sauliusc/antweight-workshop-2024-modifications/docs/readme.md

## Antweight robotukų gamybos dirbtuvės @ Kaunas Makerspace

https://github.com/makerspacelt/antweight-workshop-2024/

Iš pradžių sugalvokite robotuko vardą ir pasakykite mentoriui.
Vardą ir valdymo programą reikės įrašyti į robotuko atmintį.
Tada ieškokite detalių ir konstruokite:

| | |
| :--- | :--- |
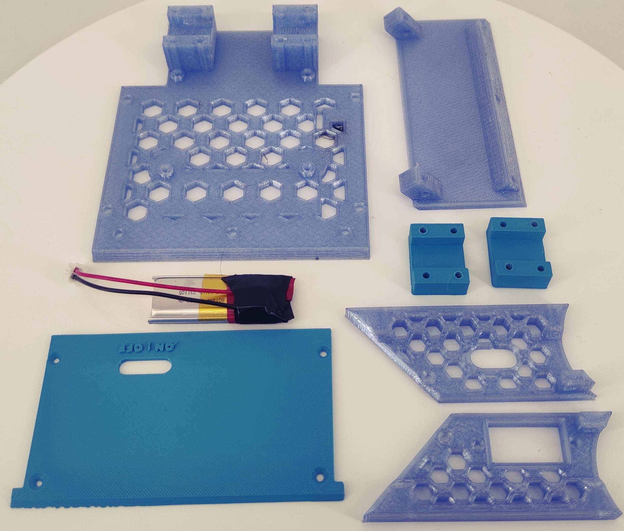
[picture p1: docs/base-parts.jpg]
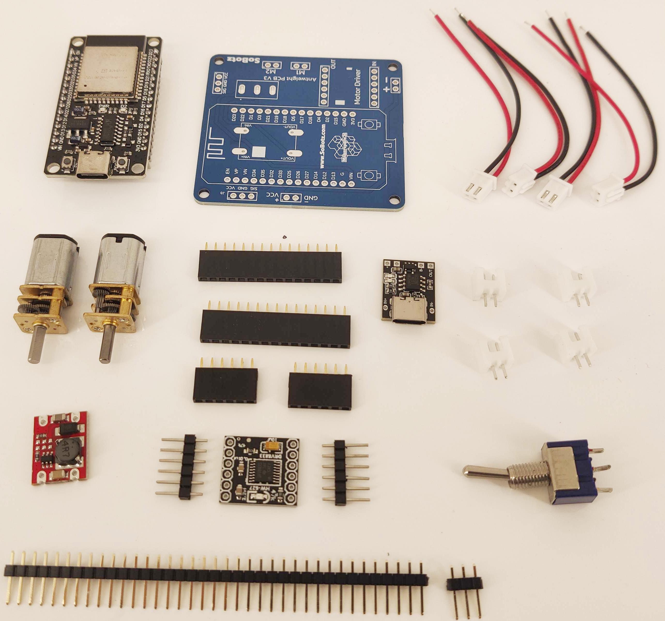
[picture p2: docs/electronic-parts.jpg]
| Korpuso dalys ir baterija: | Visos elektronikos dalys:  |

| | |
| :--- | :--- |
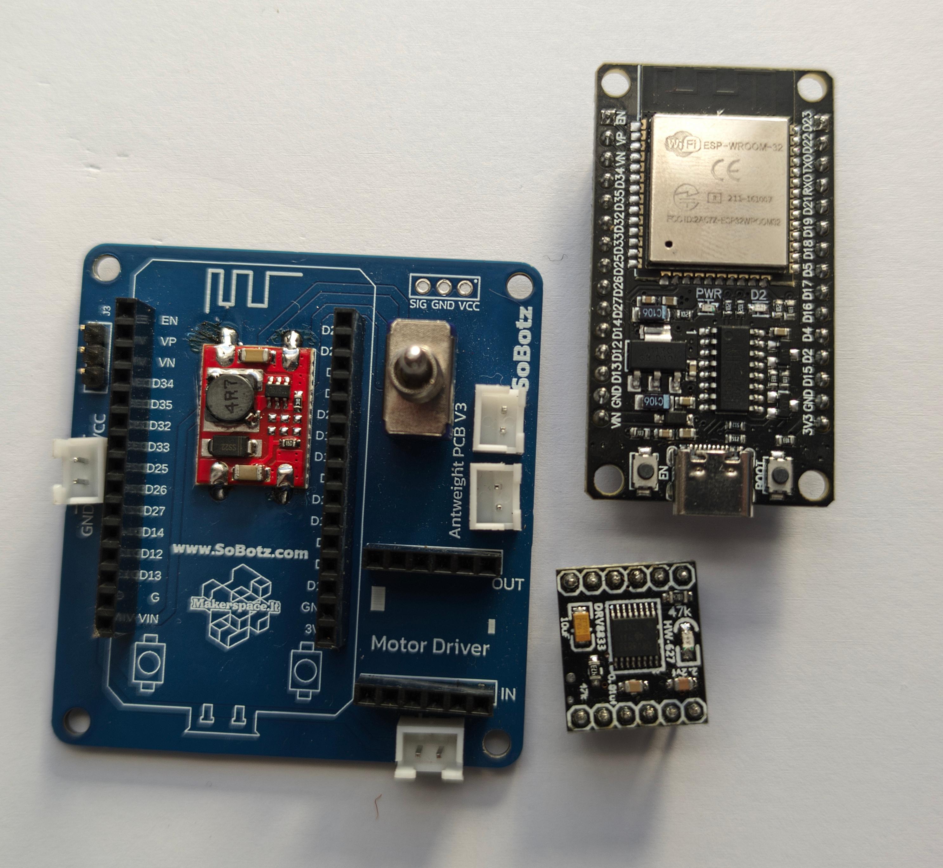
[picture p3: docs/pcb-soldered.jpg]
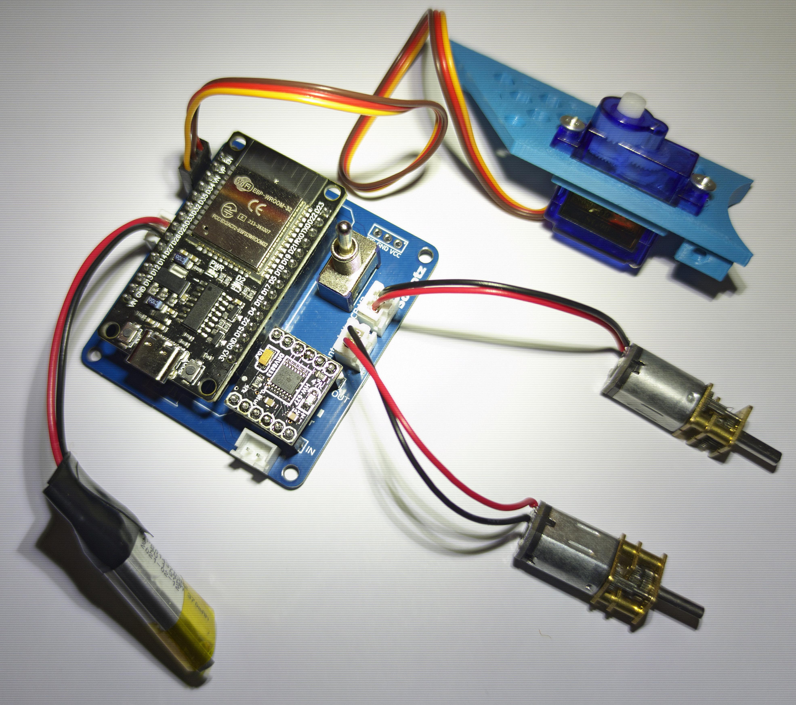
[picture p4: docs/pcb-connected.jpg]
| Sulituota plokštė:  | Sujungta elektronika:  |

| | |
| :--- | :--- |
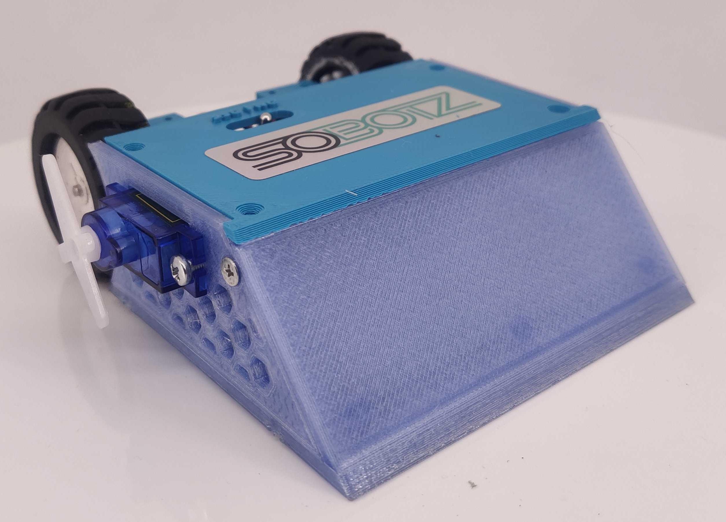
[picture p5: docs/assembled.jpg]
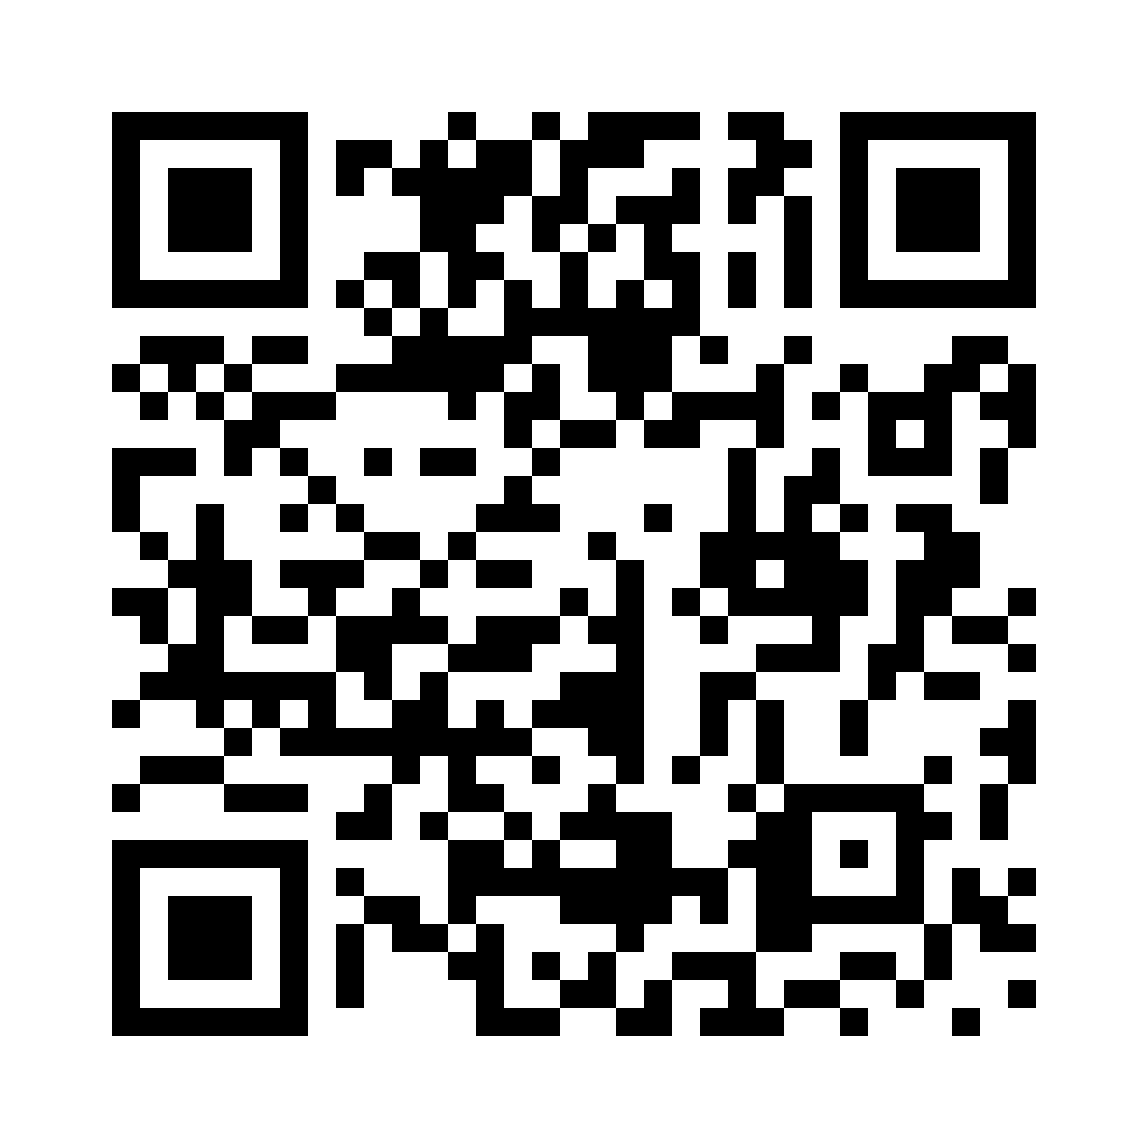
[picture p6: docs/qr-control-app.png]
| Surinktas robotukas:  | Nuoroda į valdymo programą (atidarykite su Google Chrome Android telefone):  |

<style>
table * { border: none; }
table { border: none;}
td { vertical-align: top; }
</style>
