sauliusc/antweight-workshop-2024-modifications/bg2.jpg

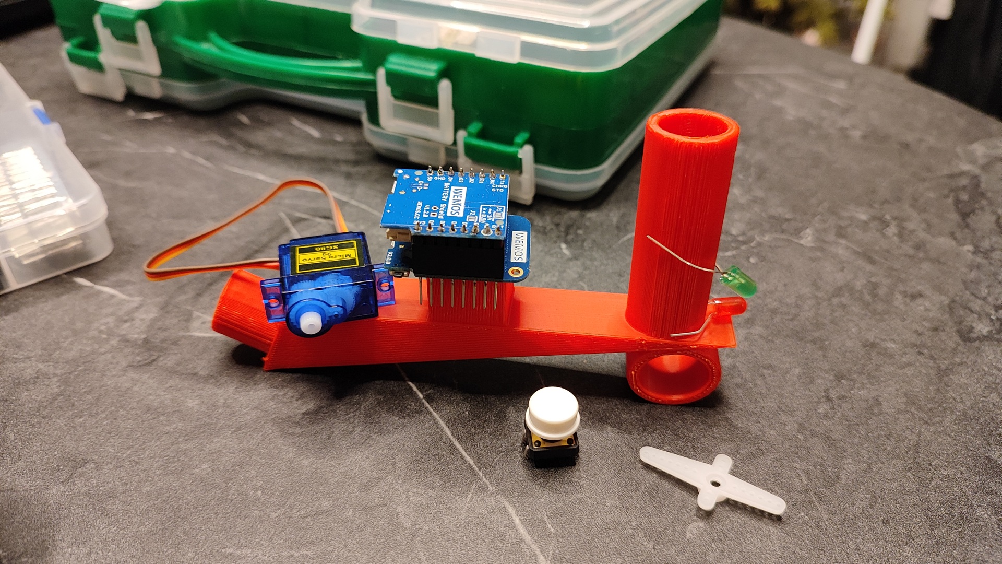
bg2.jpg
