sauliusc/antweight-workshop-2024-modifications/(commit log)

2024-11-19 updated debug info and returned device info
2024-11-19 removed flag accept all devices
2024-11-19 removed device filter
